mannatvjain/aoe-mario-kart/assets/photos/25-component-kit.jpg

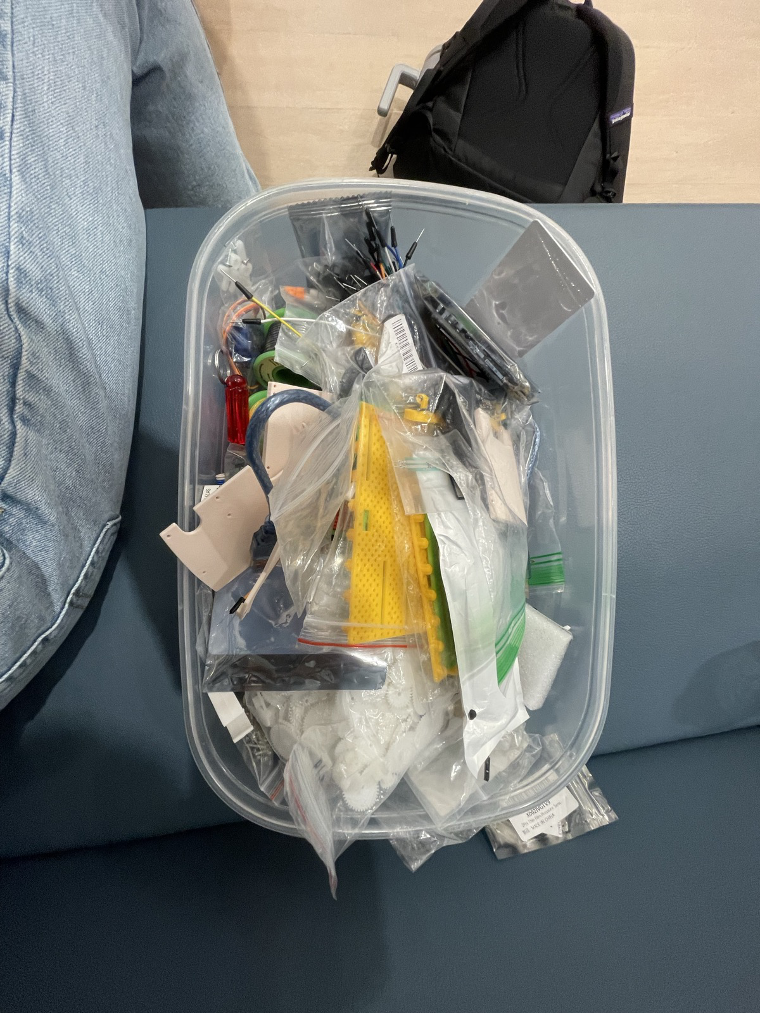
assets/photos/25-component-kit.jpg
