mannatvjain/aoe-mario-kart/assets/photos/18-xiao-wiring-angle4.jpg

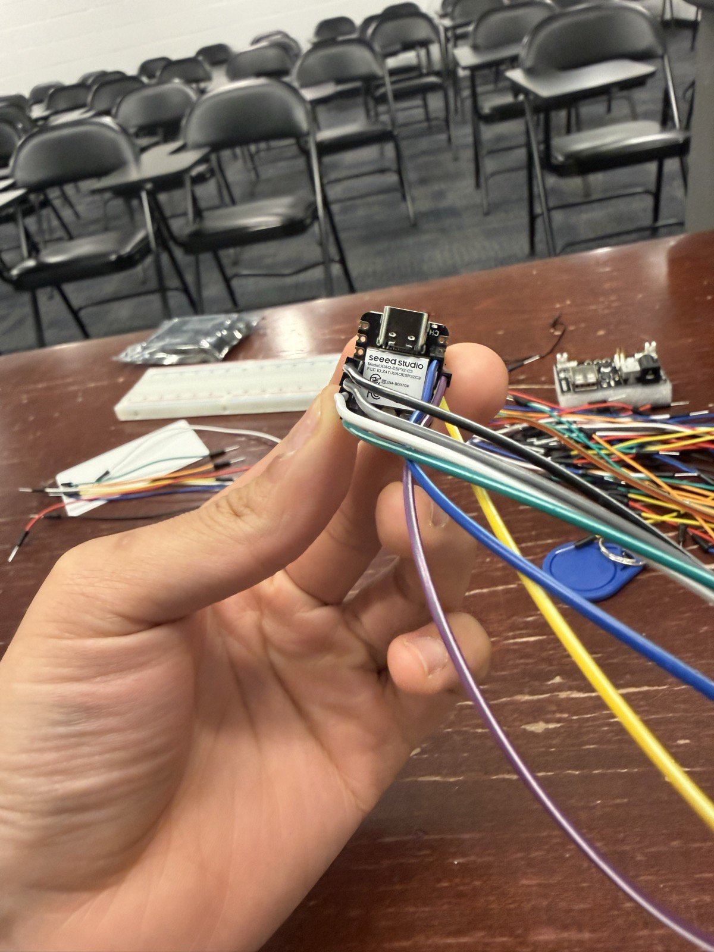
assets/photos/18-xiao-wiring-angle4.jpg
