mannatvjain/aoe-mario-kart/INDEX.md

# Index

## Documentation
| File | Purpose |
|---|---|
| `CLAUDE.md` | Project instructions, architecture, agent protocol |
| `INDEX.md` | This file — map of the repository |
| `PLAN.md` | Task checklist with progress tracking |
| `LOG.md` | Reverse-chronological session changelog |
| `WIRING.md` | Full wiring guide: pin assignments, power architecture, component list |
| `Puppet.md` | Hardware assembly session log with compliance tracking |

## Code
| File | Purpose |
|---|---|
| `src/rfid_test.ino` | Basic RFID tag scanning test sketch |
| `src/rfid_test/rfid_test.ino` | RFID test (duplicate/subfolder version) |
| `src/rfid_display_test.ino` | RFID + display test sketch |
| `src/mario_kart.ino` | Main game firmware (tag UIDs, game logic) |
| `src/controller.py` | Laptop-side BLE controller script |

## Assets
| File | Purpose |
|---|---|
| `assets/photos/` | Hardware assembly photos (23 images) |
| `assets/famin_audio_1_2143.mp3` | Teammate voice memo — requirements (controller, motor, servo, lap timer, leaderboard) |
| `assets/famin_audio_2_2144.mp3` | Teammate voice memo — requirements (force sensor bumper, second ESP option) |
| `assets/famin_audio_1_2143_transcript.md` | Transcript of audio 1 |
| `assets/famin_audio_2_2144_transcript.md` | Transcript of audio 2 |
