mannatvjain/aoe-mario-kart/assets/famin_audio_1_2143_transcript.md

# Famin Audio 1 — Transcript (2026-04-23)

Source: `famin_audio_1_2143.mp3`

---

Okay, Claude. So the ESP needs to be connected to a game controller so that it can drive the car. The game controller is going to have two joysticks, one joystick to control if it goes left or right, and the other one to move front and back.

So the motor is going to be connected to a motor driver. It's a DRV8833, and it should run PWM and PID.

And the ESP should also be connected to a servo, and a servo should have certain customizable rotations such that we can test how much the servo can rotate for the rack and pinion steering mechanism.

And the ESP should also be connected to a charging port, and the charging port, I guess, connected to everything.

So let's see if there's anything else.

Not much. I guess one more thing. The ESP should also run an internal clock that should time the car around the entire track, and after three laps it should record how much time it has. And give a signal to the computer through its Wi-Fi slash Bluetooth regarding how much time a specific user has scored. And then that should be put into a leaderboard. Thank you, Claude.
