mannatvjain/aoe-mario-kart/assets/famin_audio_2_2144_transcript.md

# Famin Audio 2 — Transcript (2026-04-23)

Source: `famin_audio_2_2144.mp3`

---

If the ESP has no other space, use another ESP. So, assume that we have two ESPs and we can connect both of them.

So, the ESP should also be connected to a force sensor, actually. And the force sensor should give a maximum threshold that we can customize such that this is for the bumper to check for collisions. So, let the code be easy to write such that we can see how much force threshold the bumper will feel and give a signal such that the bumper is, the car is now slowed down and everything.
