mannatvjain/aoe-mario-kart/assets/photos/03-xiao-box-label.jpg

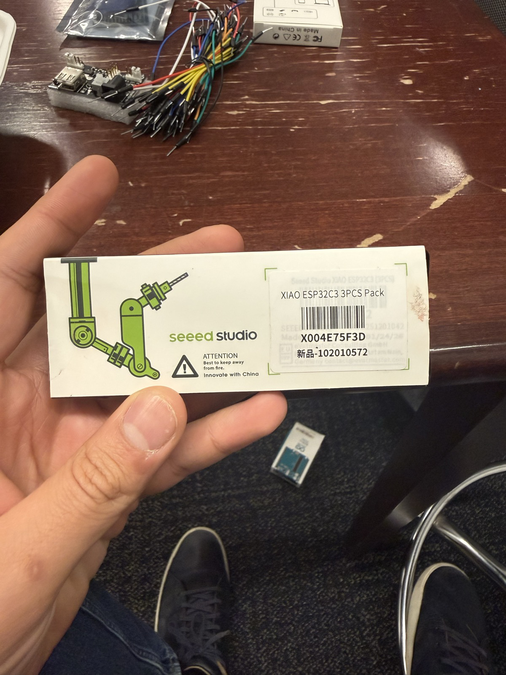
assets/photos/03-xiao-box-label.jpg
