mannatvjain/aoe-mario-kart/assets/photos/04-xiao-box-front.jpg

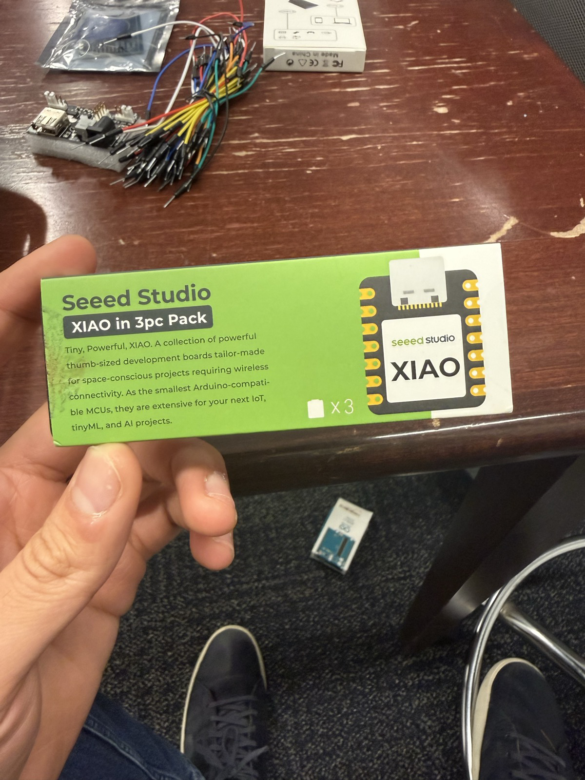
assets/photos/04-xiao-box-front.jpg
