mannatvjain/aoe-mario-kart/assets/photos/06-xiao-on-breadboard.jpg

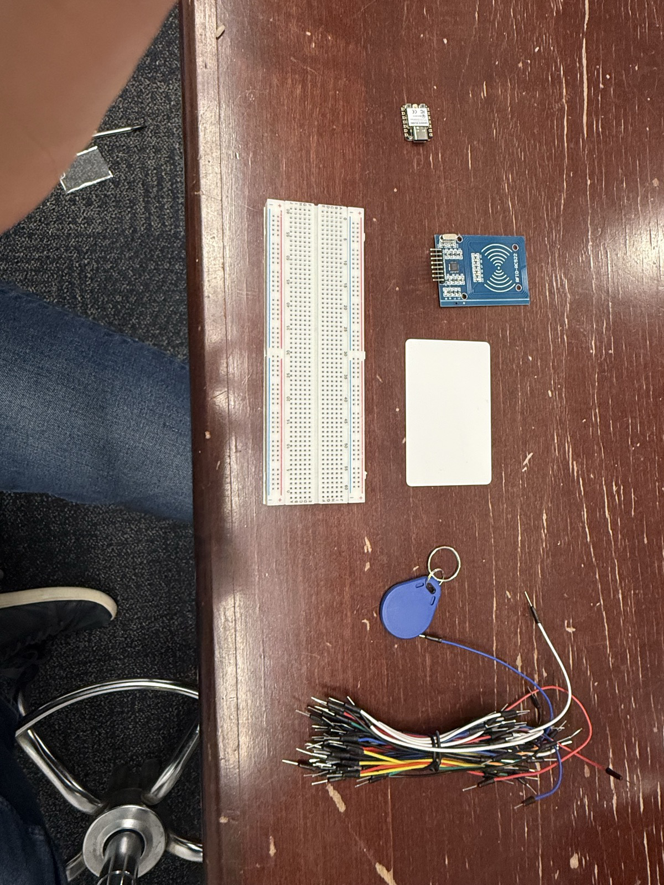
assets/photos/06-xiao-on-breadboard.jpg
