mannatvjain/aoe-mario-kart/assets/photos/07-xiao-closeup-pins.jpg

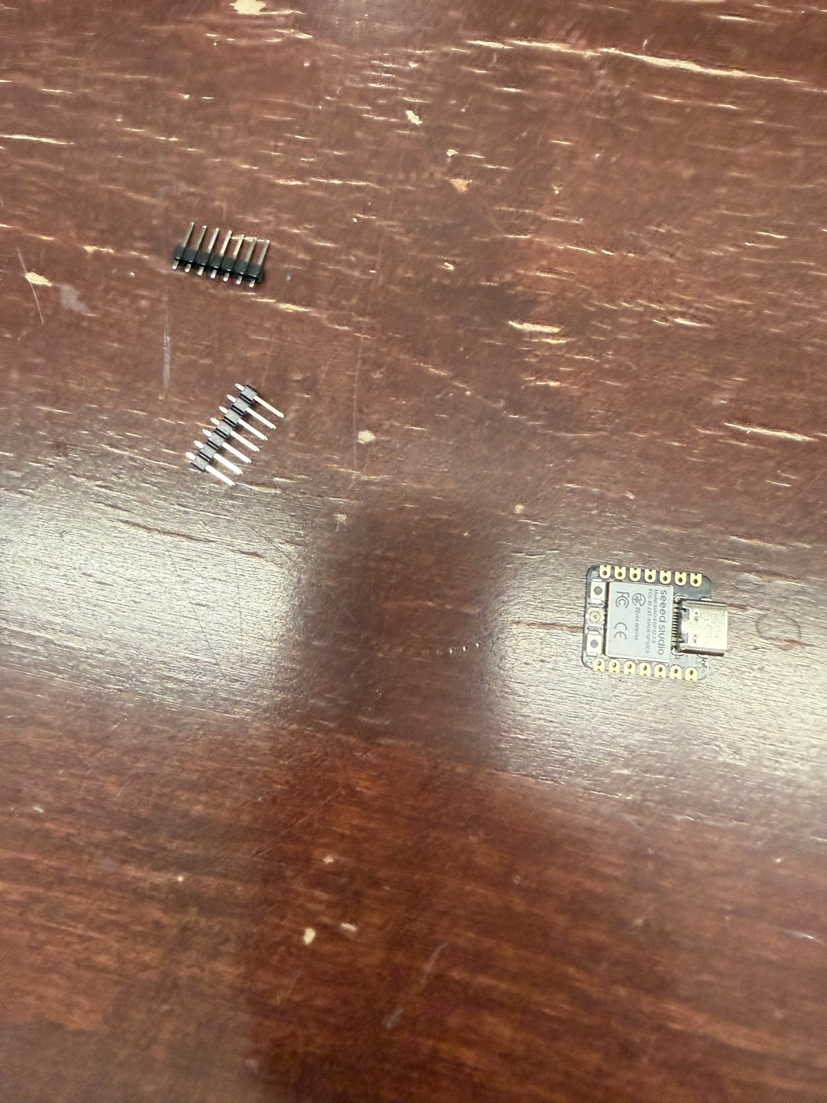
assets/photos/07-xiao-closeup-pins.jpg
