mannatvjain/aoe-mario-kart/assets/photos/08-dupont-wires-selected.jpg

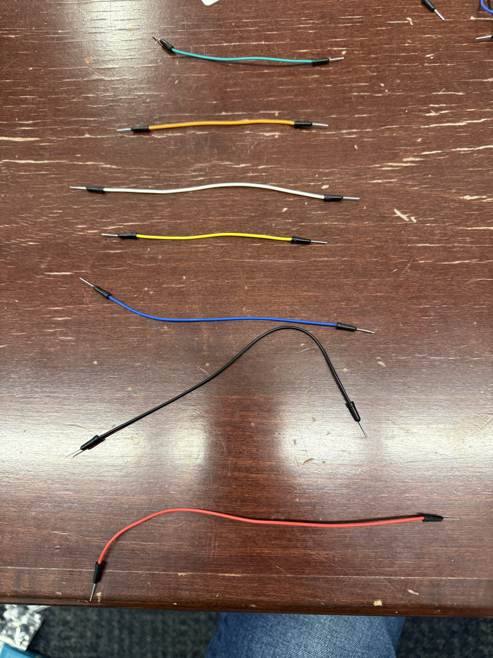
assets/photos/08-dupont-wires-selected.jpg
