mannatvjain/aoe-mario-kart/assets/photos/09-dupont-ribbon-ends.jpg

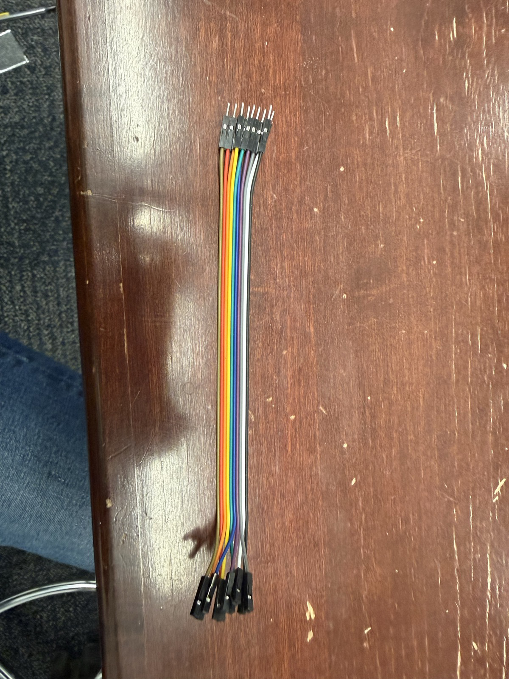
assets/photos/09-dupont-ribbon-ends.jpg
