mannatvjain/aoe-mario-kart/assets/photos/10-rc522-closeup.jpg

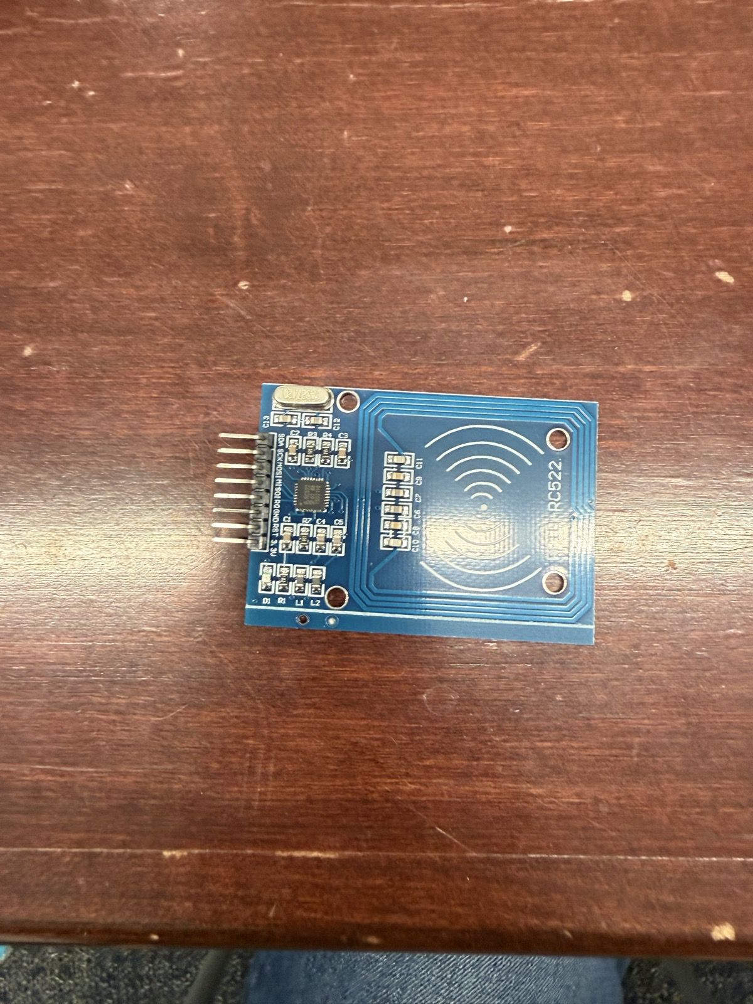
assets/photos/10-rc522-closeup.jpg
