mannatvjain/aoe-mario-kart/assets/photos/11-first-wires-connected.jpg

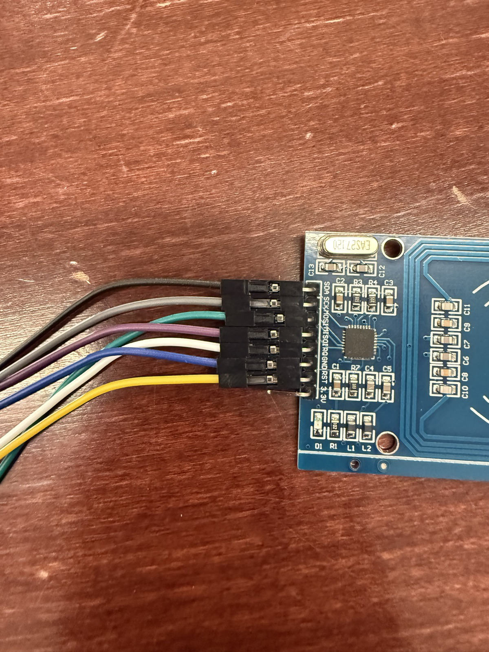
assets/photos/11-first-wires-connected.jpg
