mannatvjain/aoe-mario-kart/assets/photos/13-xiao-pin-holes.jpg

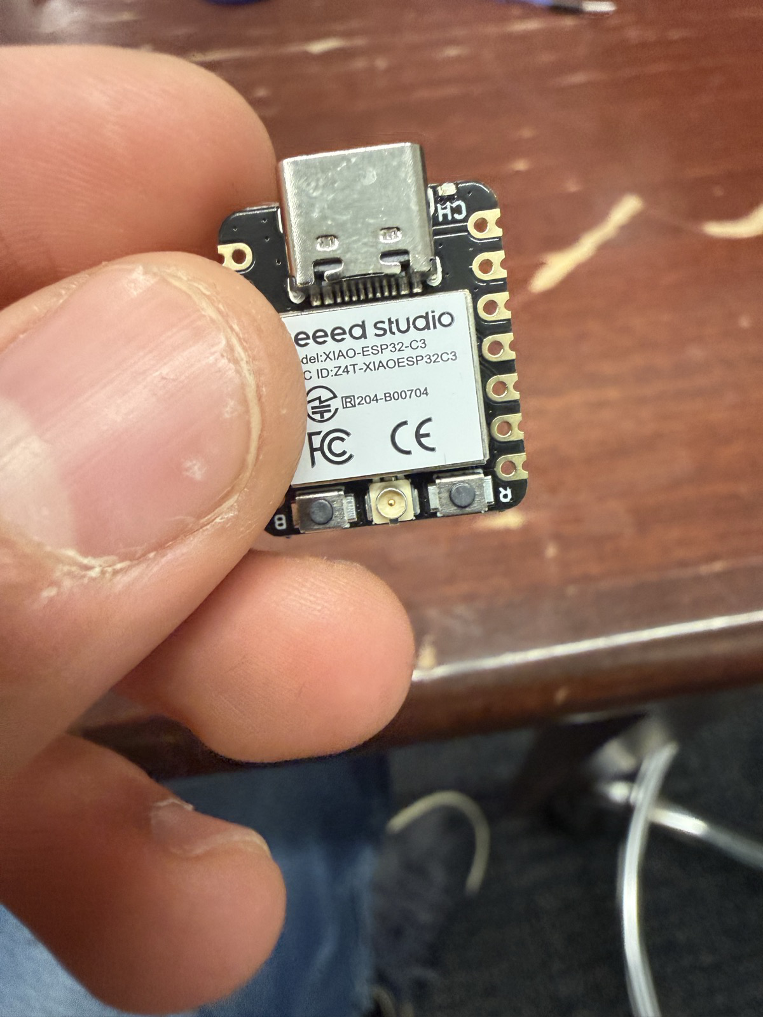
assets/photos/13-xiao-pin-holes.jpg
