mannatvjain/aoe-mario-kart/assets/photos/19-xiao-powered-on.jpg

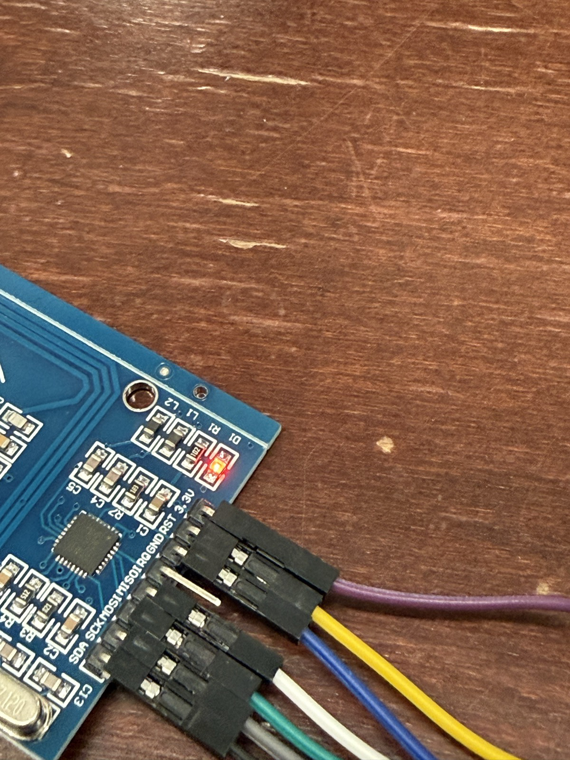
assets/photos/19-xiao-powered-on.jpg
