mannatvjain/aoe-mario-kart/assets/photos/21-unknown-board.jpg

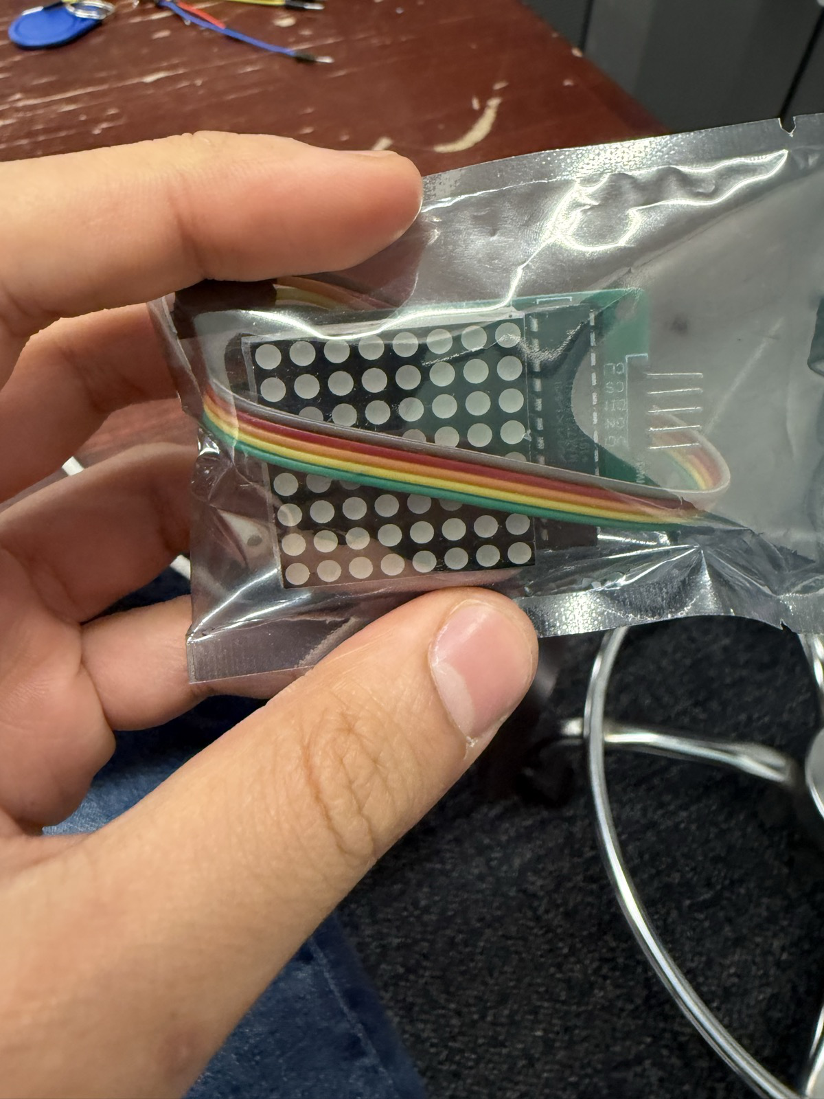
assets/photos/21-unknown-board.jpg
