mannatvjain/aoe-mario-kart/assets/photos/22-max7219-input-pins.jpg

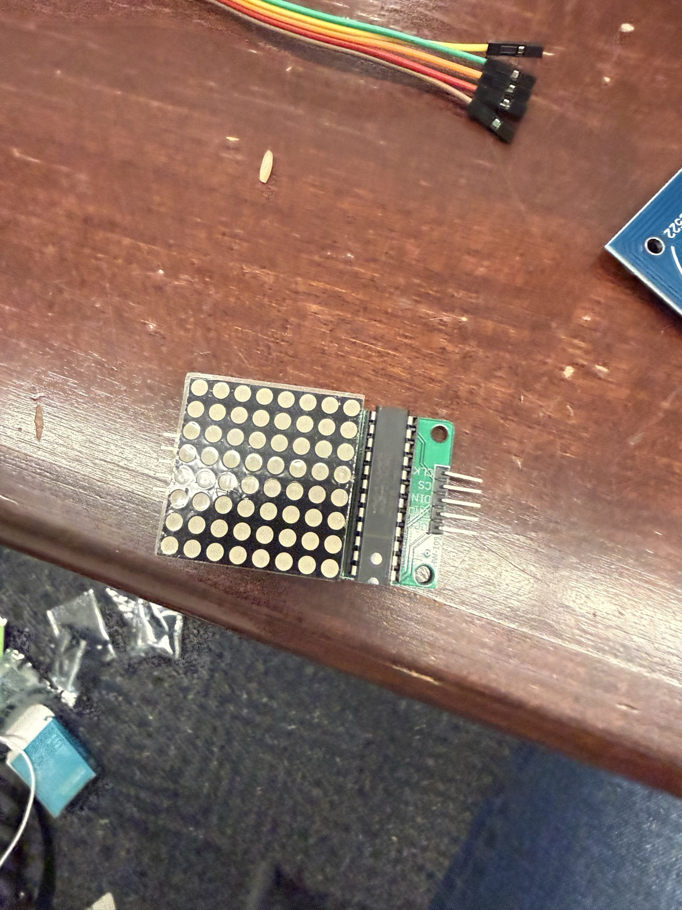
assets/photos/22-max7219-input-pins.jpg
