mannatvjain/aoe-mario-kart/assets/photos/23-max7219-labels.jpg

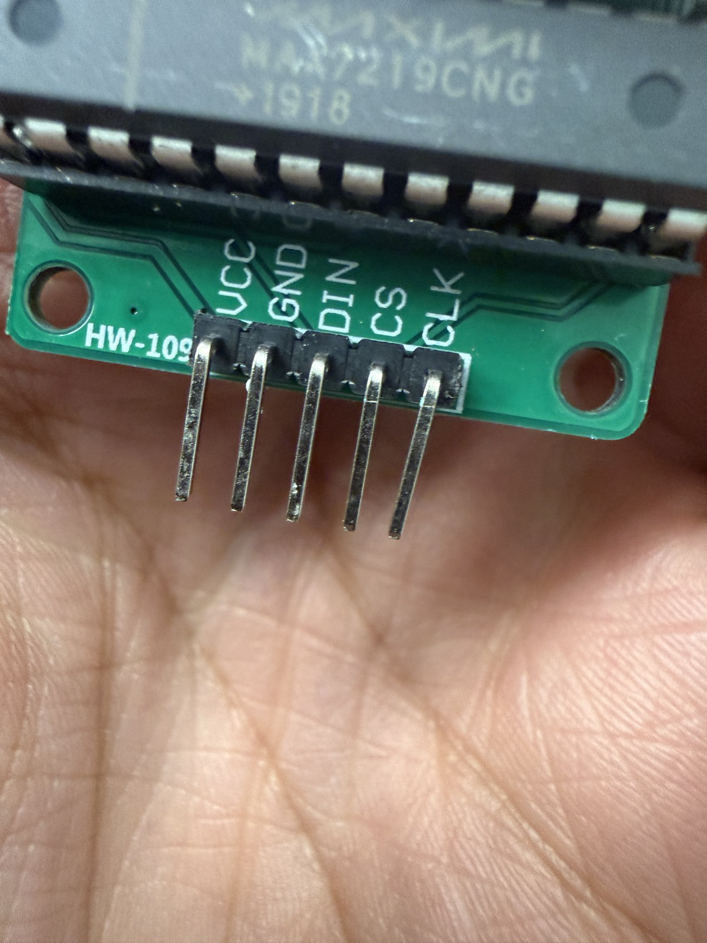
assets/photos/23-max7219-labels.jpg
