mannatvjain/aoe-mario-kart/assets/photos/26-motor-driver.jpg

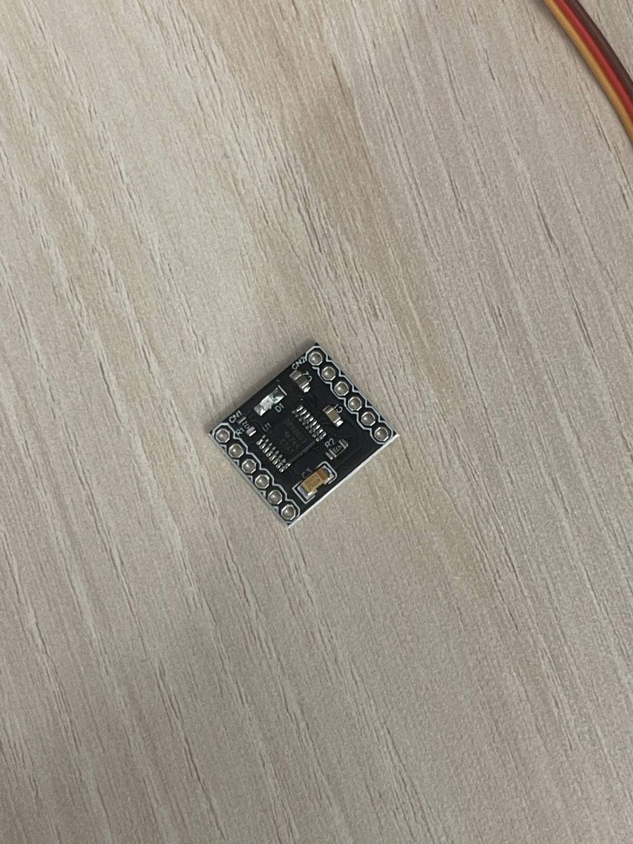
assets/photos/26-motor-driver.jpg
