mannatvjain/aoe-mario-kart/assets/photos/02-parts-floor-layout.jpg

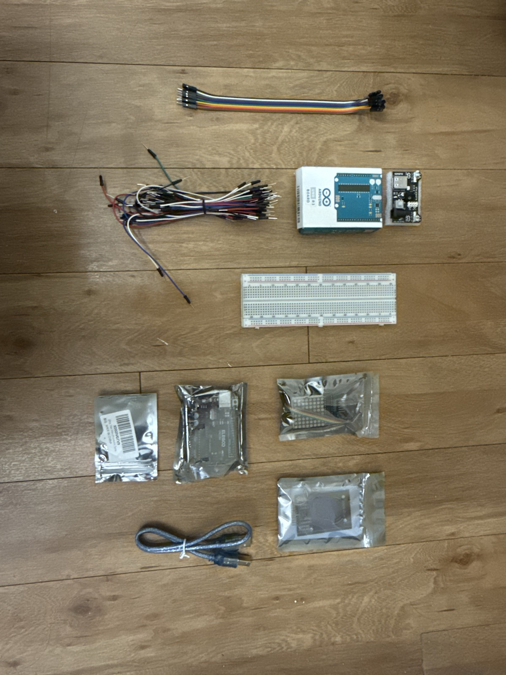
assets/photos/02-parts-floor-layout.jpg
