mannatvjain/aoe-mario-kart/assets/photos/05-unboxed-parts.jpg

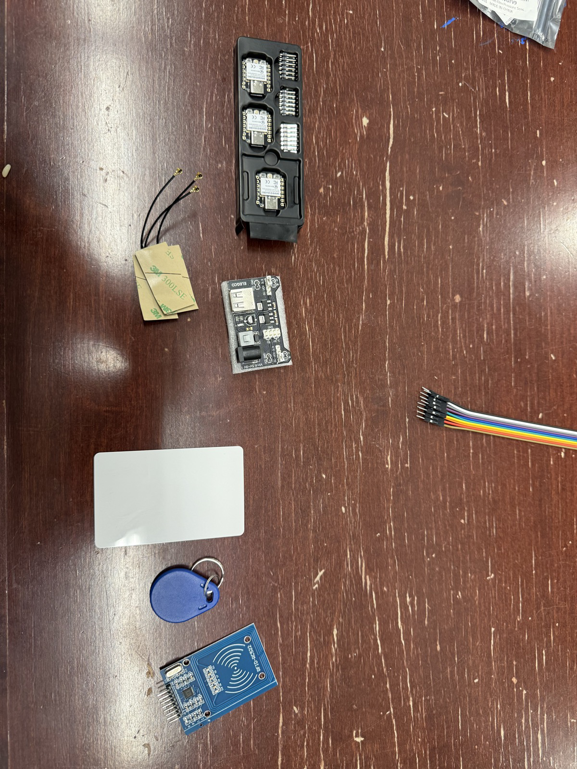
assets/photos/05-unboxed-parts.jpg
