mannatvjain/aoe-mario-kart/assets/photos/24-more-parts.jpg

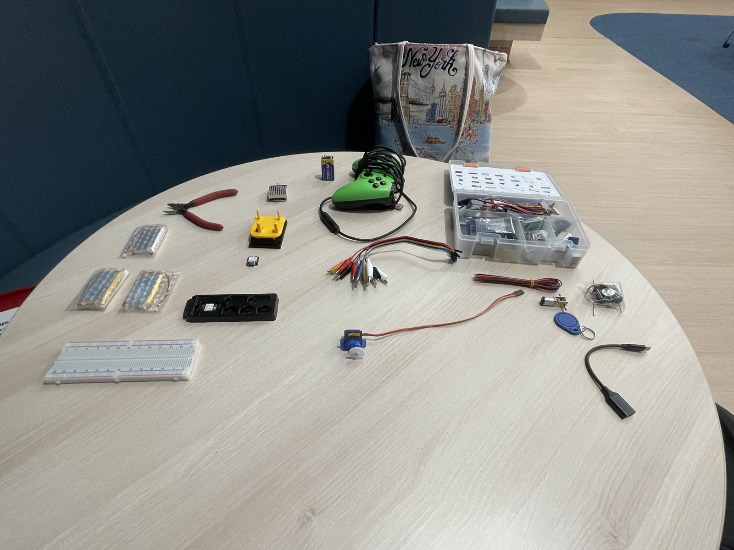
assets/photos/24-more-parts.jpg
