mannatvjain/aoe-mario-kart/assets/photos/12-xiao-side-wiring.jpg

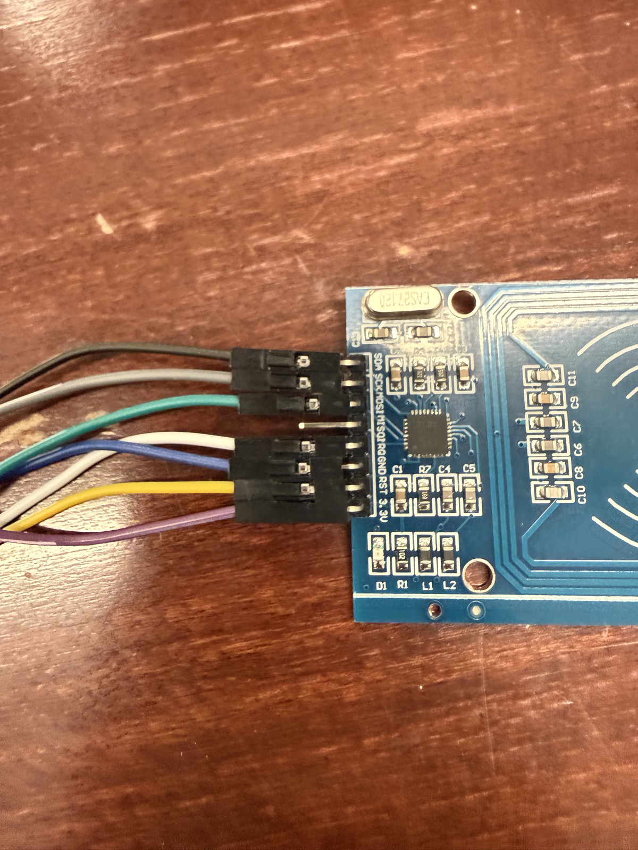
assets/photos/12-xiao-side-wiring.jpg
