mannatvjain/aoe-mario-kart/assets/photos/14-xiao-wiring-attempt.jpg

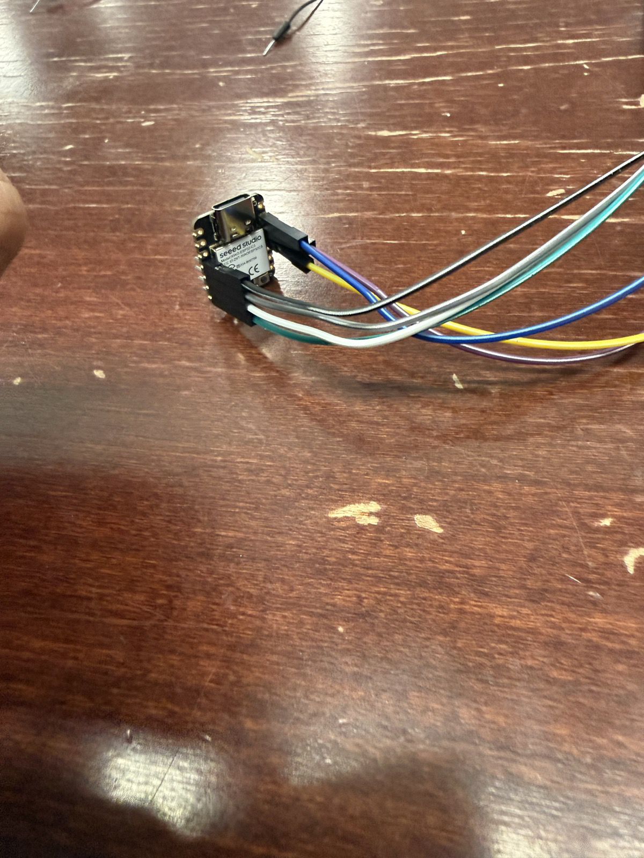
assets/photos/14-xiao-wiring-attempt.jpg
