mannatvjain/aoe-mario-kart/assets/photos/15-xiao-wiring-front.jpg

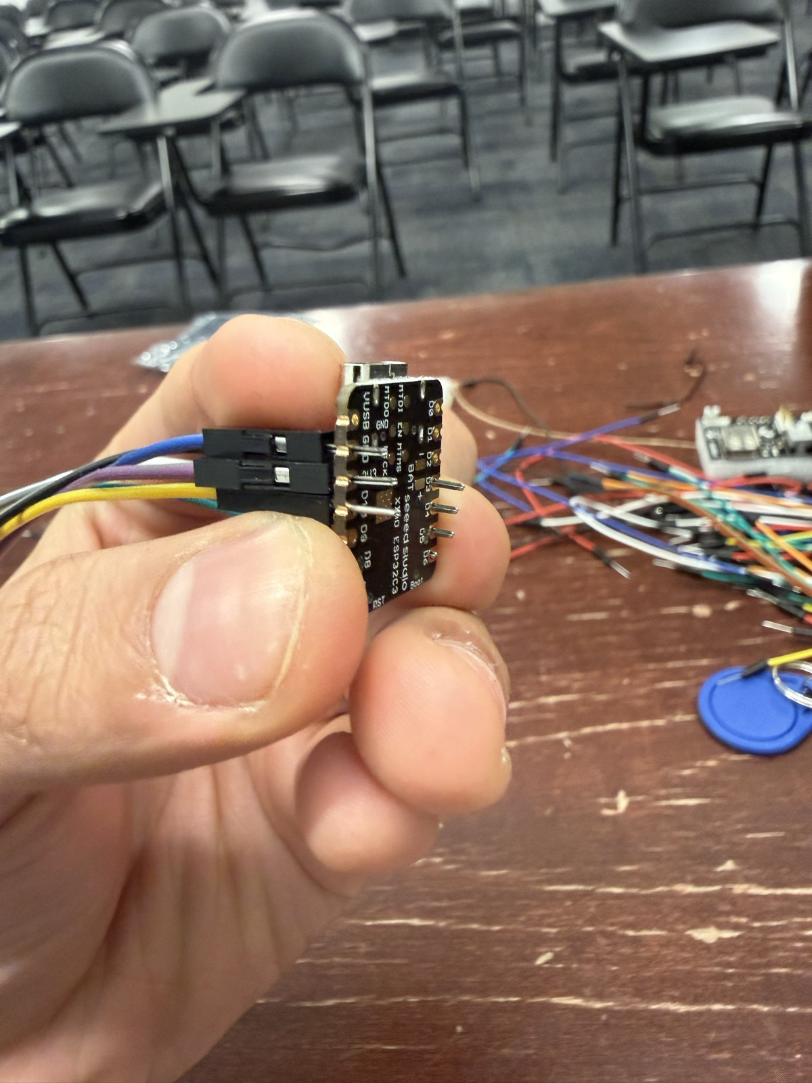
assets/photos/15-xiao-wiring-front.jpg
