mannatvjain/aoe-mario-kart/assets/photos/16-xiao-wiring-angle2.jpg

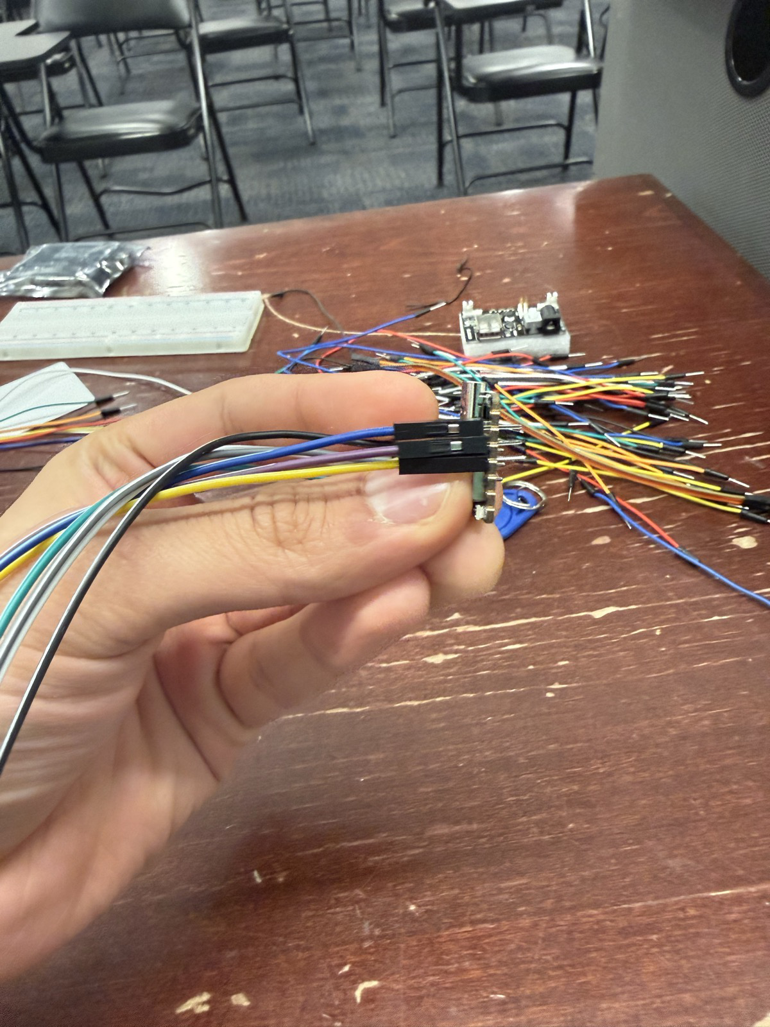
assets/photos/16-xiao-wiring-angle2.jpg
