mannatvjain/aoe-mario-kart/assets/photos/17-xiao-wiring-angle3.jpg

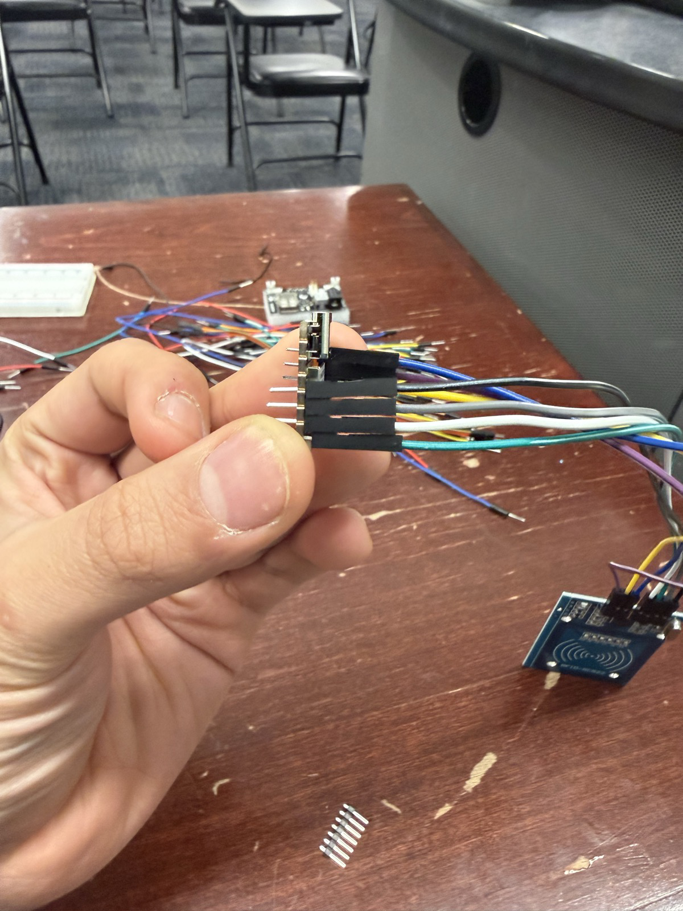
assets/photos/17-xiao-wiring-angle3.jpg
