mannatvjain/aoe-mario-kart/assets/photos/20-full-setup-powered.jpg

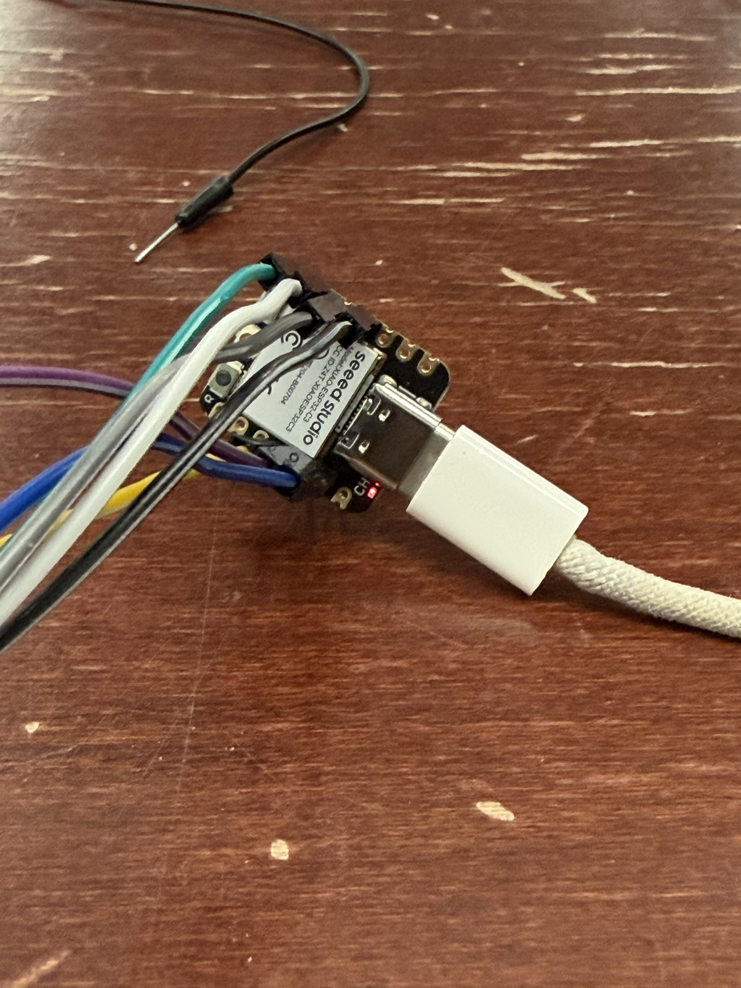
assets/photos/20-full-setup-powered.jpg
