mannatvjain/aoe-mario-kart/assets/photos/27-current-setup.jpg

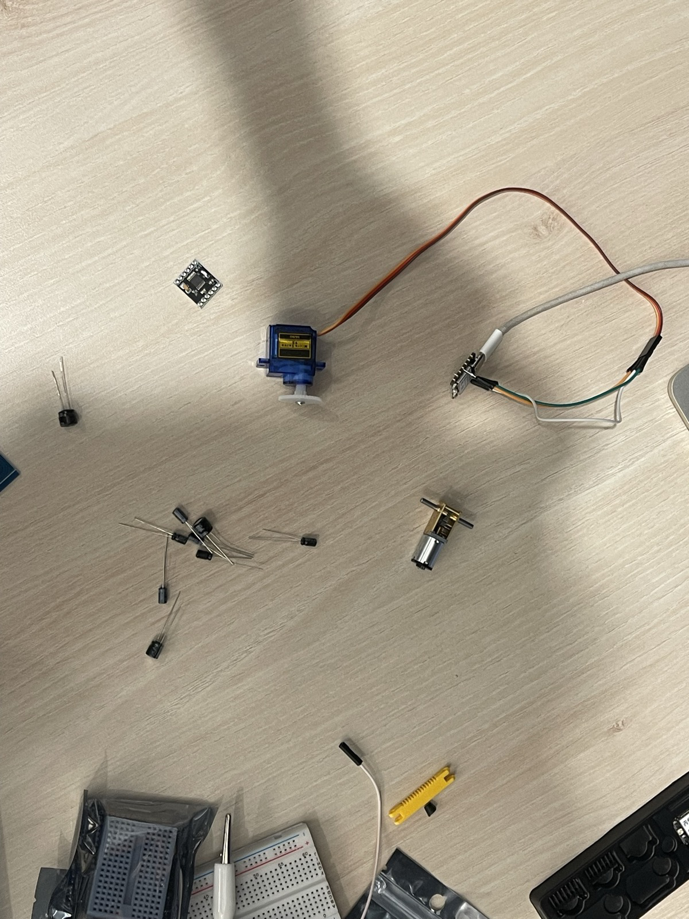
assets/photos/27-current-setup.jpg
