mannatvjain/aoe-mario-kart/(commit log)

2026-04-23 Add complete wiring guide, ESP32 firmware, and laptop BLE controller
2026-04-23 Remap all pin assignments for XIAO ESP32C3
    The actual board is a Seeed XIAO ESP32C3, not a full DevKit.
    Only 11 GPIOs available — remapped SPI, motor, servo, and RFID
    pins to fit. Updated both firmware and wiring doc.
2026-04-23 RFID system verified working, tag UIDs captured, MAX7219 code ready
    - Fixed SPI pin initialization for XIAO ESP32C3 (defaults differ from standard ESP32)
    - Scanned both RFID tags: white card (D2:A3:9C:1B) = lap marker, blue fob (56:B3:6D:AF) = powerup
    - Saved UIDs into game code
    - Added rfid_test sketch (standalone RFID scanner)
    - Added rfid_display_test sketch (RFID + MAX7219 combined, untested pending solder)
    - Full puppet log with photos in Puppet.md
    [mario_kart.ino, rfid_display_test.ino, rfid_test.ino]
2026-04-23 Add teammate voice memos, transcripts, and full project plan
    Transcribed Famin's two audio memos covering next steps: game controller
    with dual joysticks, DRV8833 PWM+PID motor control, servo steering,
    lap timer, BLE leaderboard, and force sensor bumper. Updated PLAN.md
    with 5-phase roadmap and INDEX.md with code/assets sections.
2026-04-23 Add servo and BLE tests, update puppet log
    - servo_test: sweep test confirming SG90 works on XIAO D2
    - ble_servo_test: BLE + servo combined, laptop controls steering wirelessly
    - Both tests verified working on XIAO ESP32C3
    - Updated Puppet.md with full session progress
2026-04-23 Add solder checklist and Famin handoff doc
    - SOLDER_LIST.md: everything that needs soldering in one session
    - FAMIN_HANDOFF.md: full status, priorities, gotchas, and instructions for teammate
2026-04-23 Fix: Meera → Mira Roditi everywhere
